JonMuller/gerbers/README.md

# gerbers
Place to store keyboard gerbers

These are gerbers for keyboards I have tweaked to suit my needs either by adding or subtracting things from the originals.
