JonMuller/gerbers/tenax-XIAO/README.md

###Updatre as of 04/14/23### Modified ZMK starter files for newest updates. Should work as is.

###Update as of 03/11/23### Added build pics and starter files for ZMK.

###Update as of 03/06/23###
I had some of these made and I built one. Pics to follow when I have a chance, but this is confirmed as working. No issues so far. Displays and all. I will also try to post the basic ZMK files needed to get this up and running.
###End update####

Modified the original from a direct pin setup to a matrix with XIAO controllers. Removed the TRRS, added power switch (Note the board will not charge unless the power switch is in the on position) and added a place to connect a battery. 

Original can be found here: https://github.com/toniz4/tenax

This was mostly routed using Freerouting. Gerbers/BOM/CPL were auto generated by the JLCPCB Kicad Plugin.

There is an issue with the way the footprints lined up for the CPL file. I wouldn't recommend using it at this time.

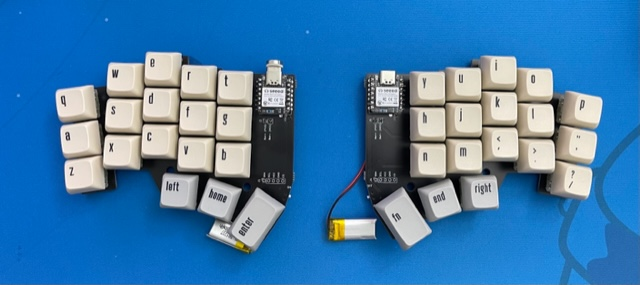
[picture p1: tenax-XIAO/Build Pics/IMG_3815.jpg]
Build1


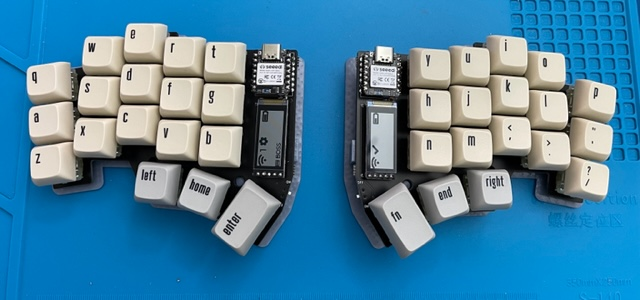
[picture p2: tenax-XIAO/Build Pics/IMG_3839.jpg]
Build2


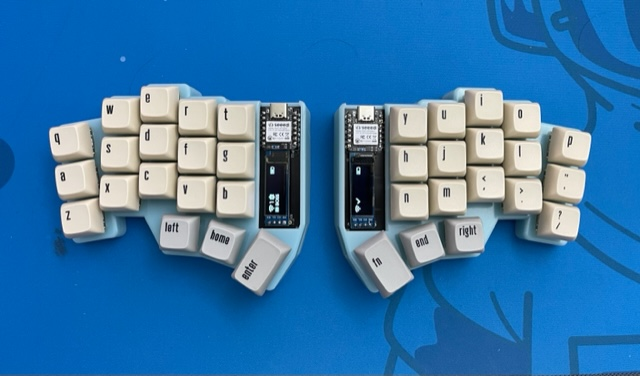
[picture p3: tenax-XIAO/Build Pics/IMG_4033.jpg]
Build3


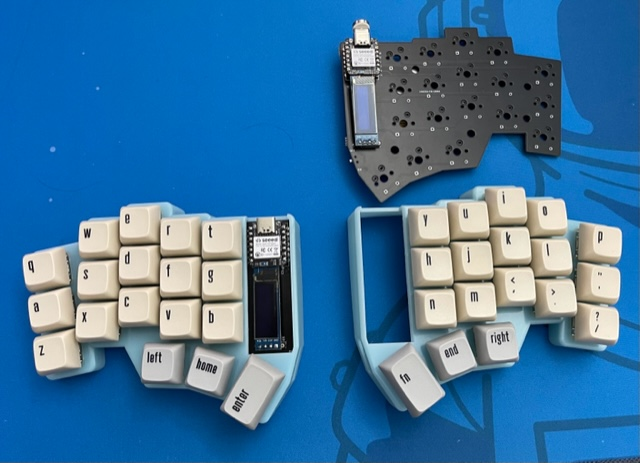
[picture p4: tenax-XIAO/Build Pics/IMG_4031.jpg]
Build4


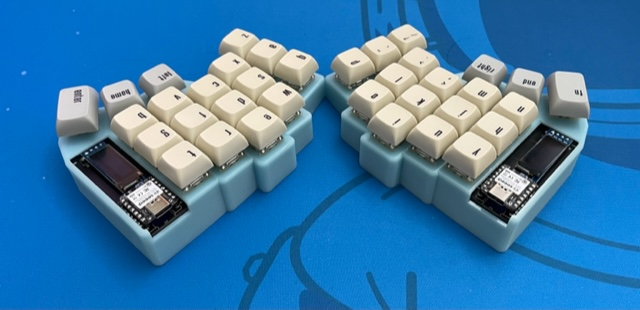
[picture p5: tenax-XIAO/Build Pics/IMG_4035.jpg]
Build5


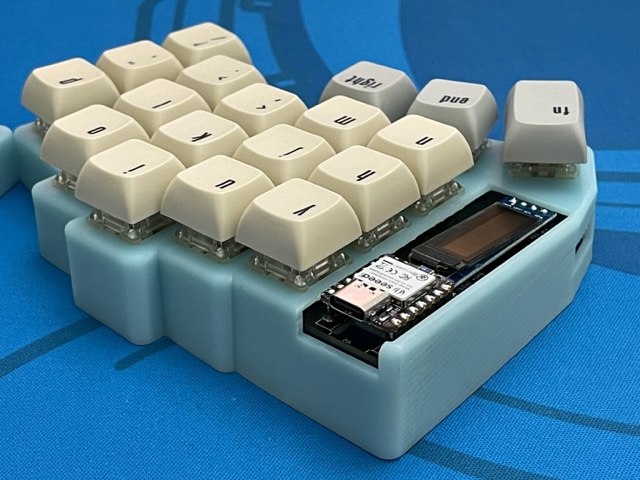
[picture p6: tenax-XIAO/Build Pics/IMG_4036.jpg]
Build6


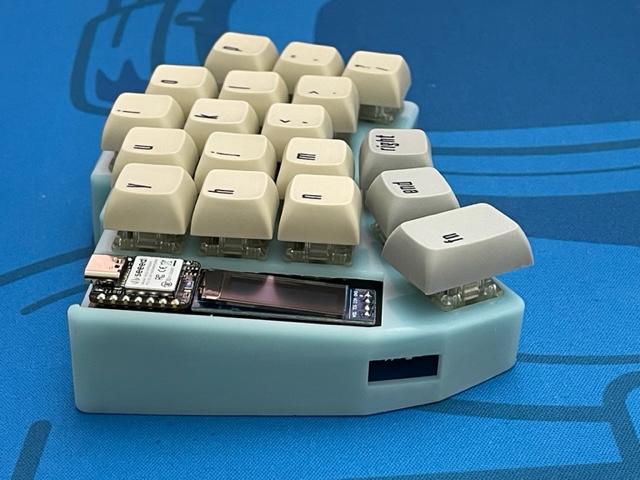
[picture p7: tenax-XIAO/Build Pics/IMG_4037.jpg]
Build7


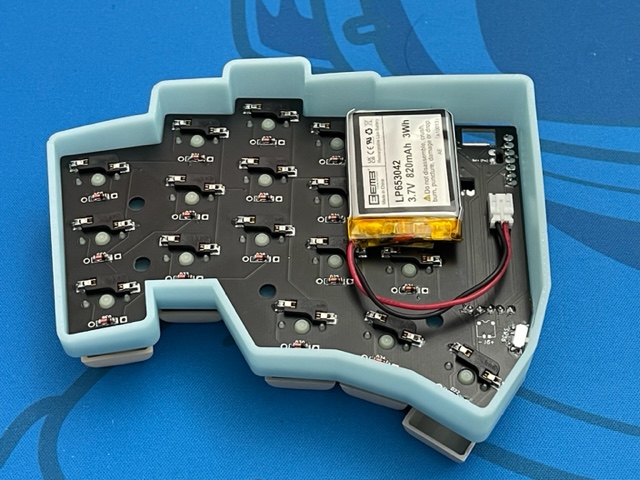
[picture p8: tenax-XIAO/Build Pics/IMG_4038.jpg]
Build8


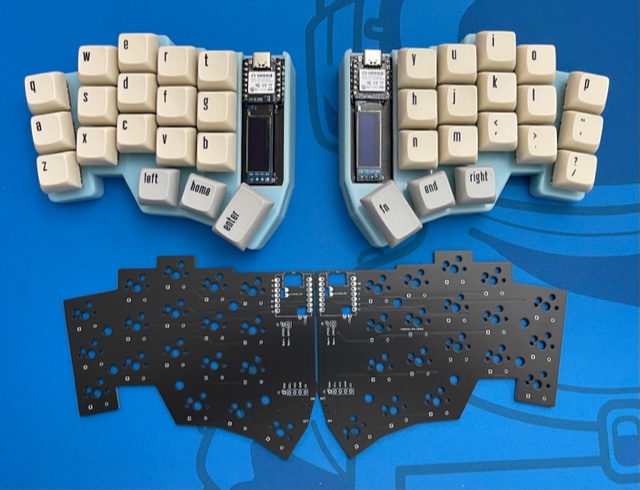
[picture p9: tenax-XIAO/Build Pics/IMG_4040.jpg]
Build9


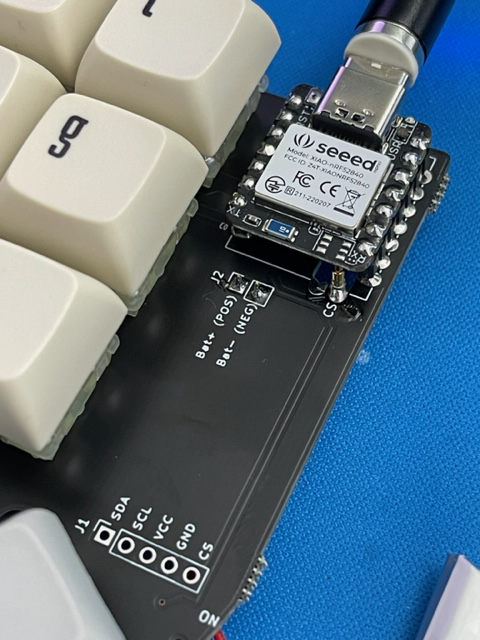
[picture p10: tenax-XIAO/Build Pics/IMG_3817.jpg]
Build10


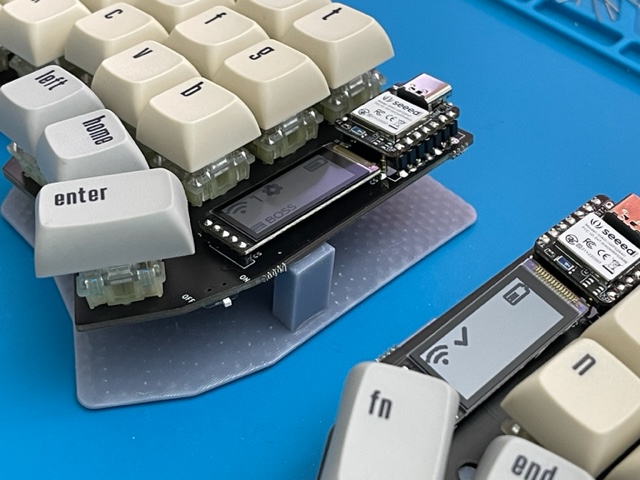
[picture p11: tenax-XIAO/Build Pics/IMG_3841.jpg]
Build11


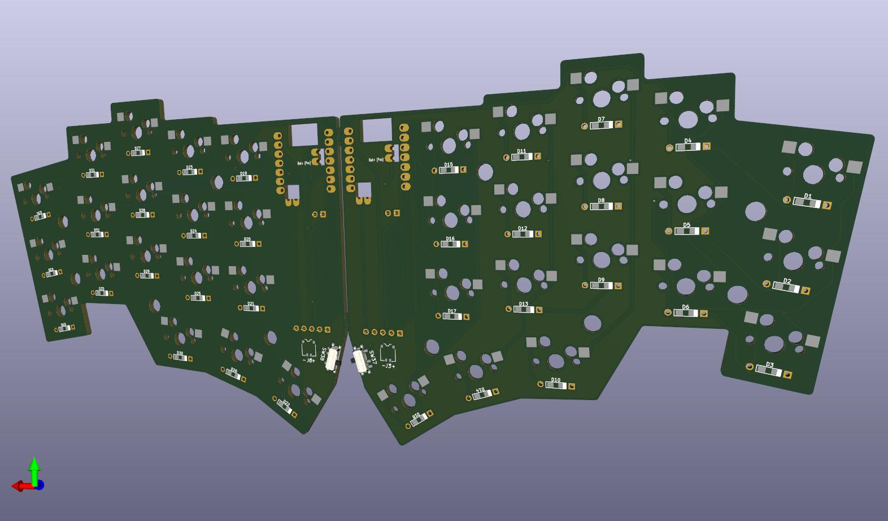
[picture p12: tenax-XIAO/tenax-XIAO Bottom.jpg]
Bottom


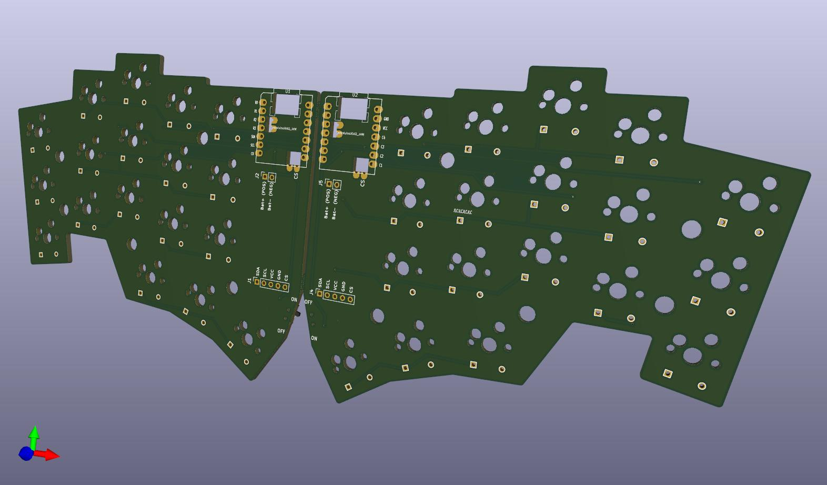
[picture p13: tenax-XIAO/tenax-XIAO Top.jpg]
Top


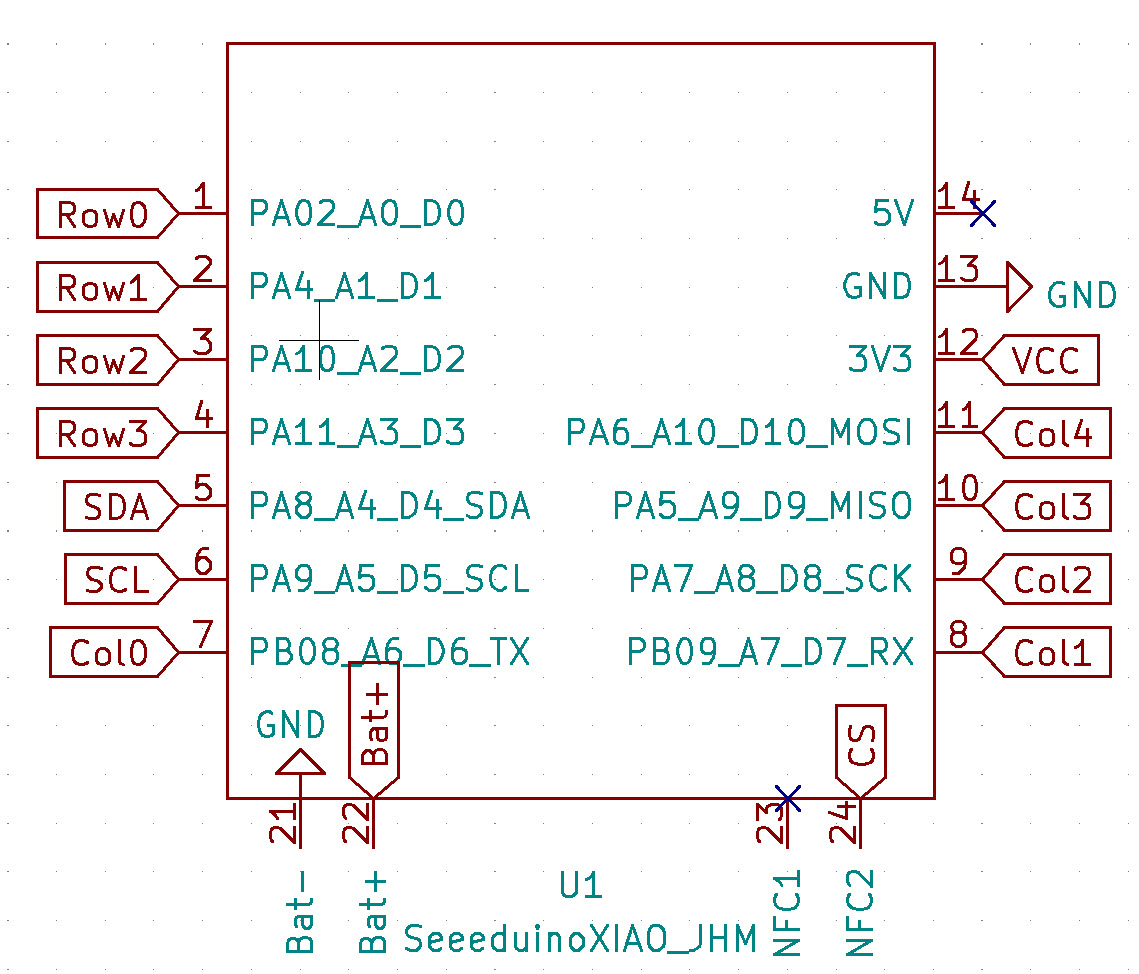
[picture p14: tenax-XIAO/XIAO_Connections.jpg]
Connections


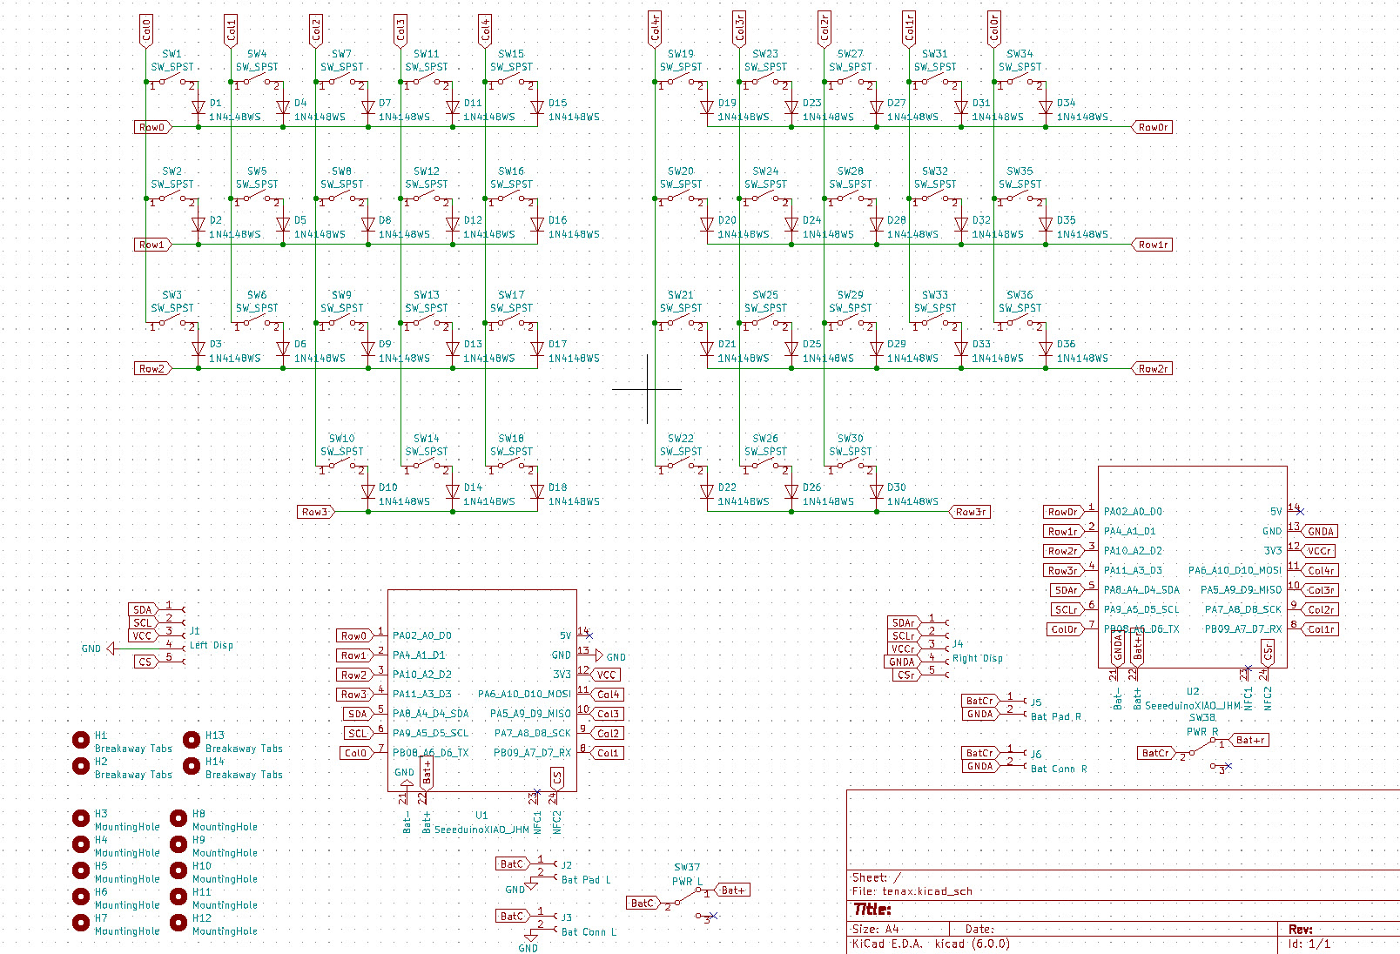
[picture p15: tenax-XIAO/Schematic.jpg]
Schematic
