JonMuller/gerbers/WirelessSofle/Alt_Switch/README.md

This is an alternate power switch layout. It uses much larger slide switches that can be easily mounted on either side as they are through hole.

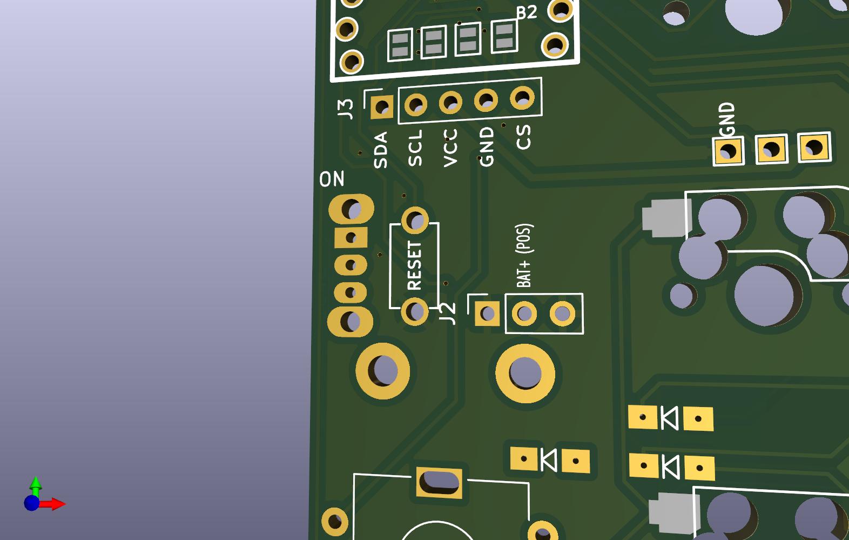
[picture p20: WirelessSofle/Alt_Switch/Closup_on_switch.jpg]
Switch Close Up

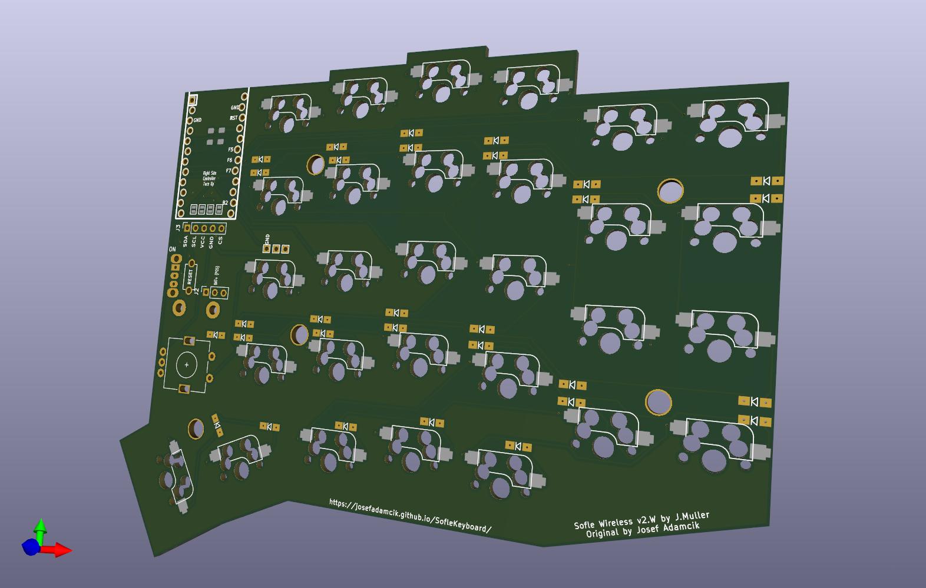
[picture p21: WirelessSofle/Alt_Switch/SofleKeyboard Top.jpg]
Top

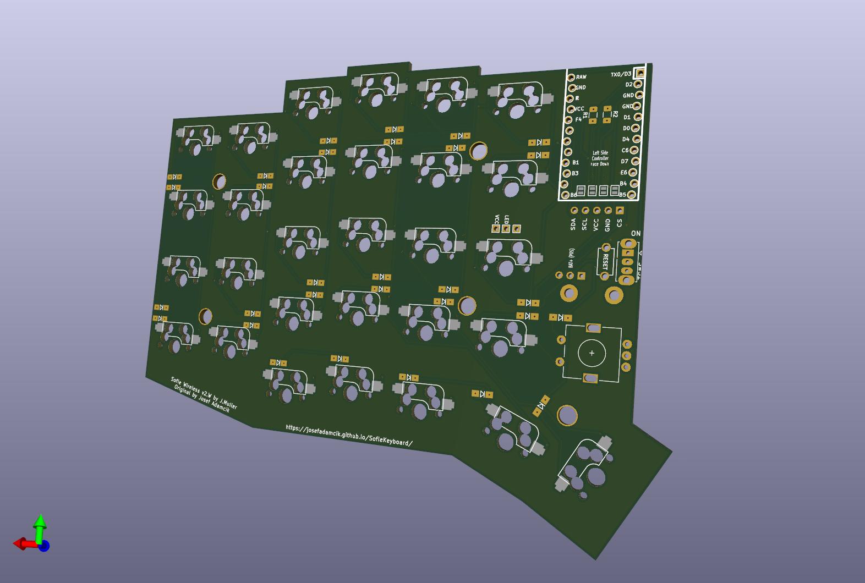
[picture p22: WirelessSofle/Alt_Switch/SofleKeyboard bottom.jpg]
Bottom
