JonMuller/gerbers/corne-choc-xiao/schematics/choc_corne_flip.jpg

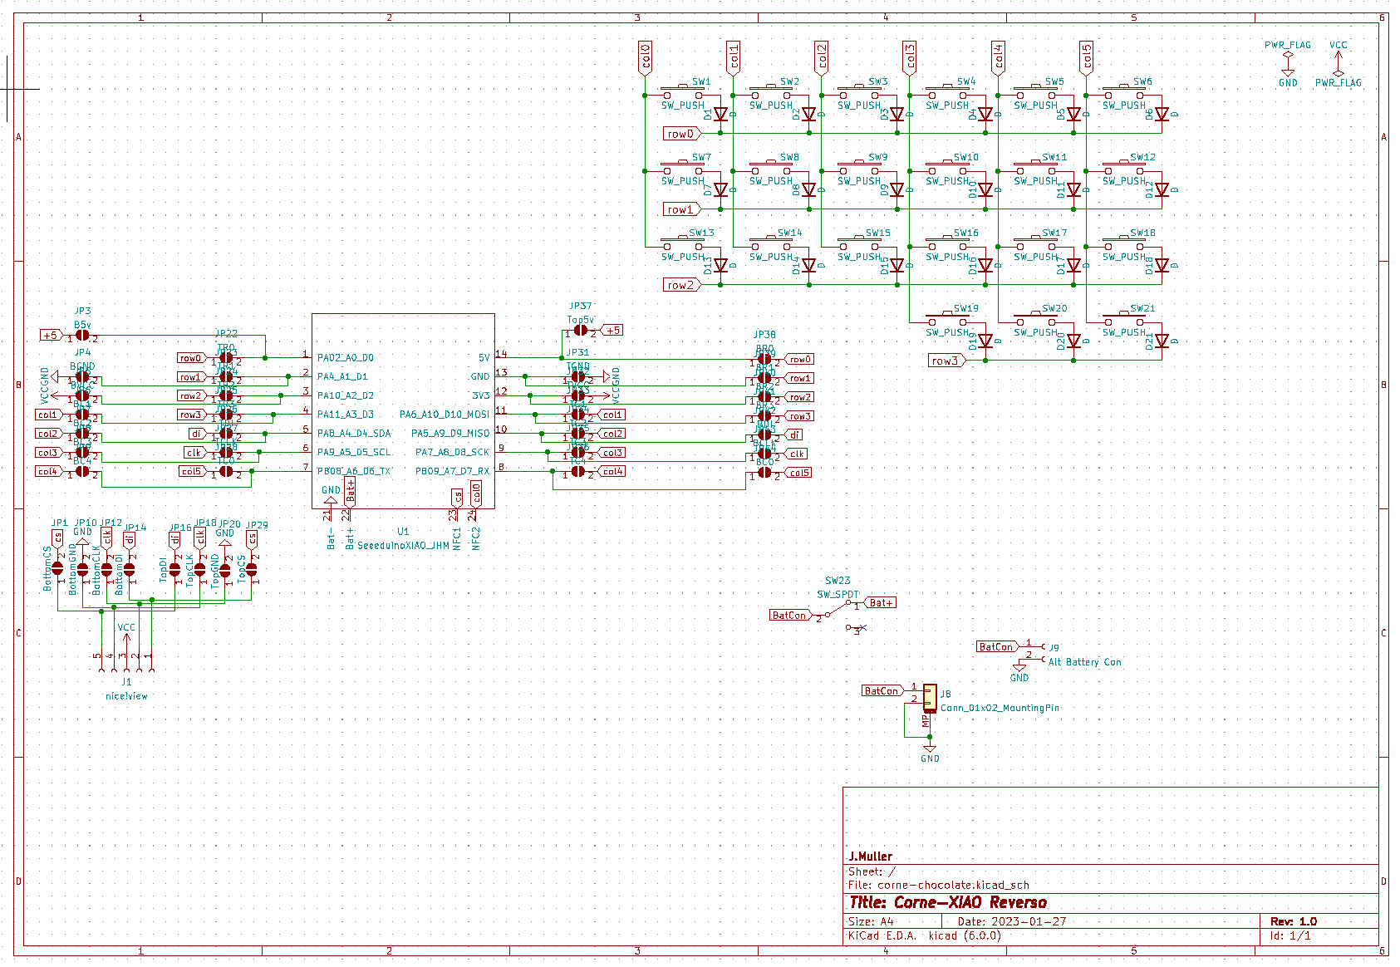
corne-choc-xiao/schematics/choc_corne_flip.jpg
