JonMuller/gerbers/corne-choc-xiao/schematics/col_rows.jpg

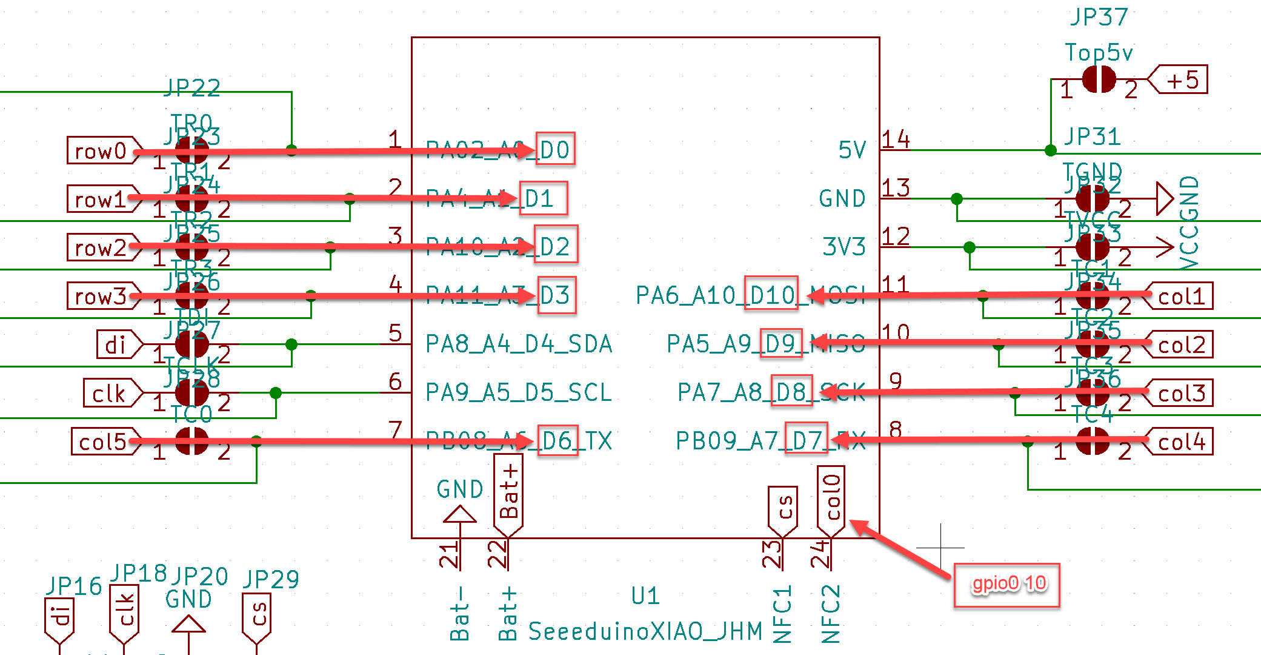
corne-choc-xiao/schematics/col_rows.jpg
