JonMuller/gerbers/corne-choc-xiao/schematics/Columns.jpg

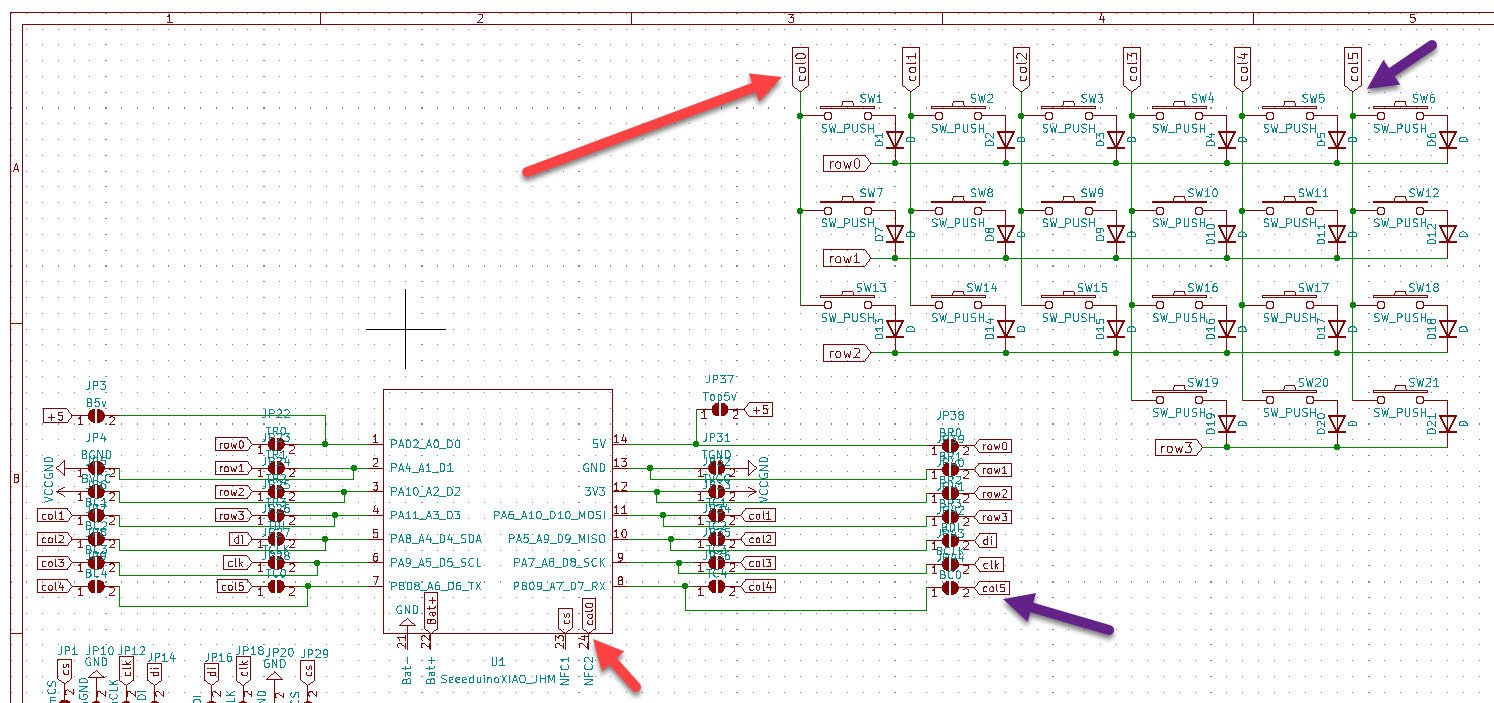
corne-choc-xiao/schematics/Columns.jpg
