JonMuller/gerbers/corne-choc-xiao/schematics/pin_def.jpg

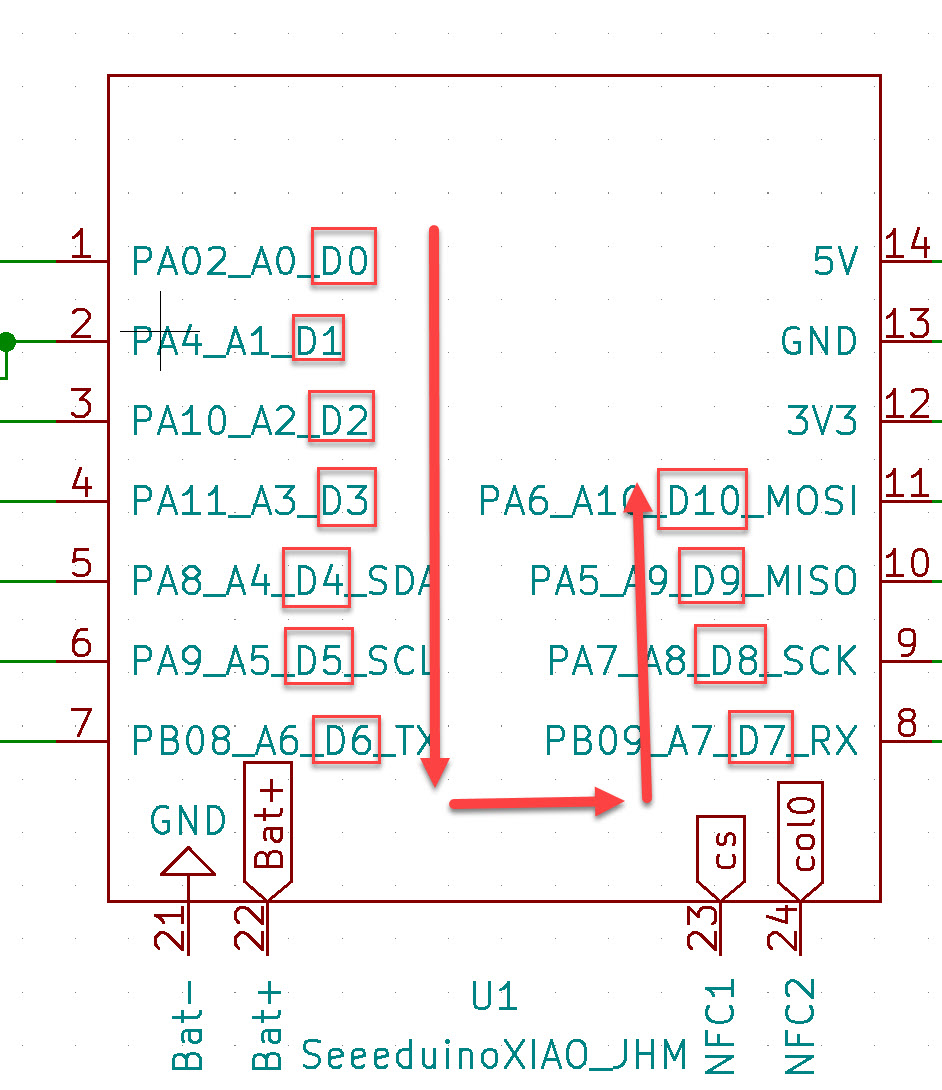
corne-choc-xiao/schematics/pin_def.jpg
