JonMuller/gerbers/tenax-XIAO/BOM-tenax.csv

Comment | Designator | Footprint | LCSC
PWR | SW38,SW37 | SW_SPDT_PCM12 | C221841
Bat Conn | J6,J3 | Molex_Pico-EZmate_78171-0002_1x02-1MP_P1.20mm_Vertical | C505023
1N4148WS | D36,D35,D34,D33,D32,D31,D30,D29,D28,D27,D26,D25,D24,D23,D22,D21,D20,D19,D18,D17,D16,D15,D14,D13,D12,D11,D10,D9,D8,D7,D6,D5,D4,D3,D2,D1, | Diode-Hybrid-Back | C2972761
