JonMuller/gerbers/ChocSpacedV4/final_choccorneV4_top_right.step

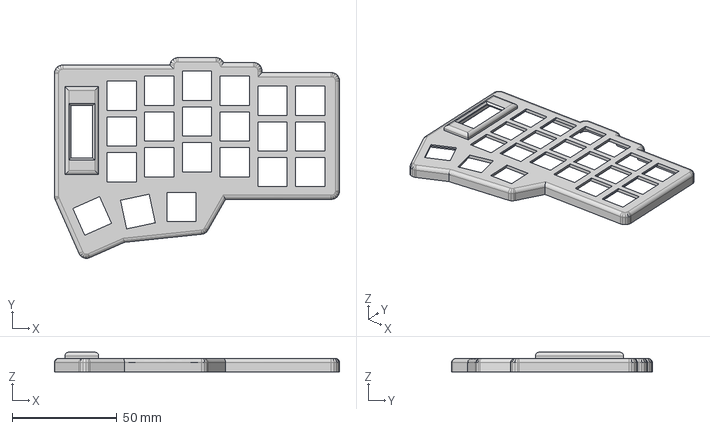
[picture p27: CAD file, 2024-07-19]
ChocSpacedV4/final_choccorneV4_top_right.step
136.1 x 95.9 x 9.40 mm
