JonMuller/gerbers/corne-choc-xiao/case/chipper_right v2.stl

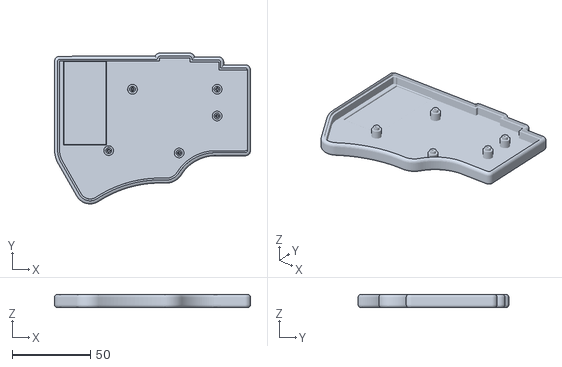
[picture p28: CAD file, 2023-03-26]
corne-choc-xiao/case/chipper_right v2.stl
125.2 x 96.3 x 8.60
