JonMuller/gerbers/tenax-XIAO/case/tenax_case_left.stl

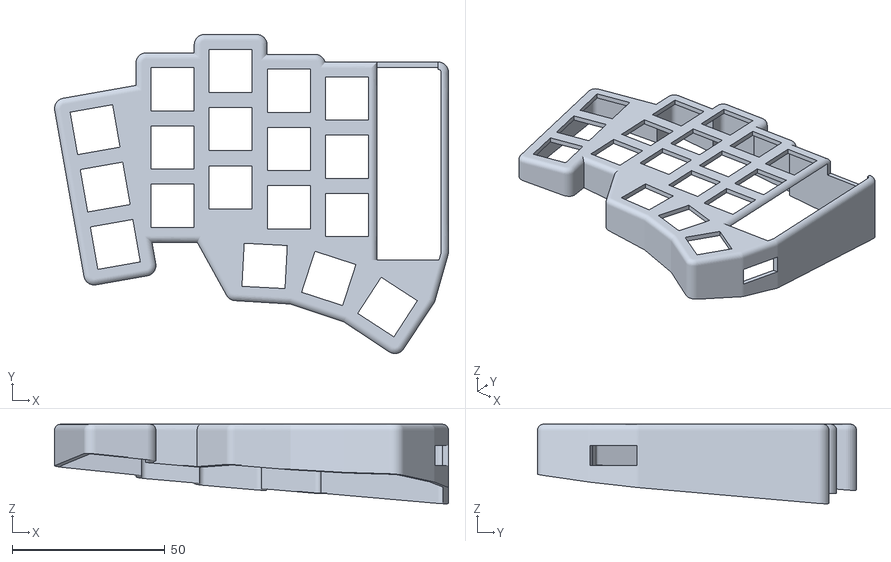
[picture p29: CAD file, 2023-05-22]
tenax-XIAO/case/tenax_case_left.stl
128.8 x 104.3 x 26.0
