JonMuller/gerbers/ChocSpacedV4/final_choccorneV4_bottom_right.step

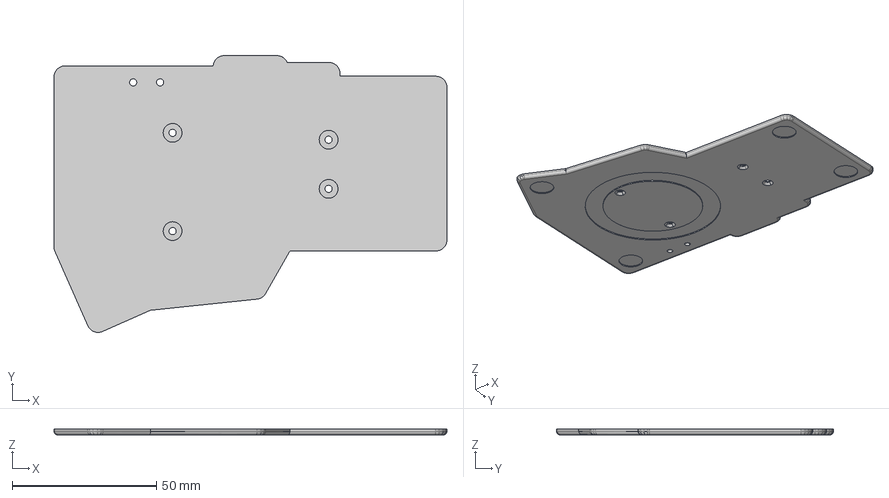
[picture p30: CAD file, 2024-07-19]
ChocSpacedV4/final_choccorneV4_bottom_right.step
136.1 x 95.9 x 2.00 mm
