JonMuller/gerbers/ChocSpacedV4/final_choccorneV4_tray_right.step

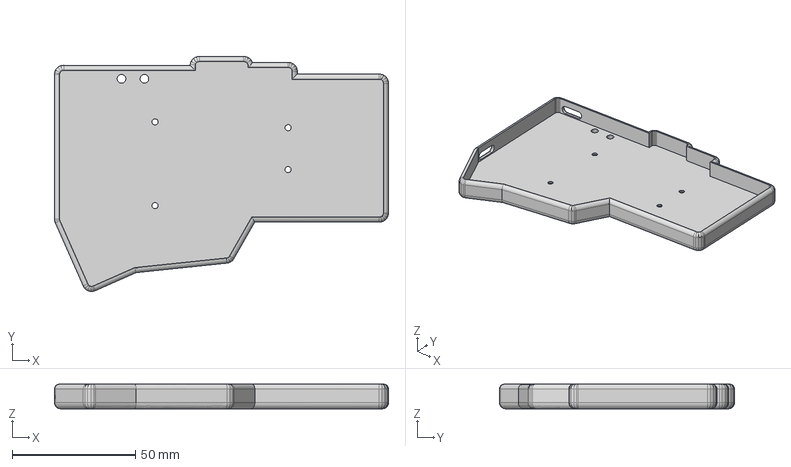
[picture p31: CAD file, 2024-07-19]
ChocSpacedV4/final_choccorneV4_tray_right.step
135.7 x 95.5 x 10.0 mm
