JonMuller/gerbers/(list of files, cad)

Other CAD files:
tenax-XIAO/case/tenax_case_right.stl
ChocSpacedV4/final_choccorneV4_top_left.step
ChocSpacedV4/final_choccorneV4_bottom_left.step
ChocSpacedV4/final_choccorneV4_tray_left.step
