JonMuller/gerbers/tenax-XIAO/Build Pics/README.md

Not surprisingly, these are a bunch of pics of an actual build.
