JonMuller/gerbers/corne-choc-xiao/experimental/ReadMe.md

This has not been validated yet. I'm attempting to upload the raw kicad files. As of 06/24/24, this is completely untested. Please let me know if this works for you or not.

Thanks and have a wonderful day!
