JonMuller/gerbers/(threads)

Thread 2 (2023-03-25):

Questions regarding battery life & 3D print case

j1n6, 2023-03-25:
Hi there, thanks for sharing the design. They look absolutely interesting. I'm planning to build one for myself.
I have a couple of questions, what is the battery life for the Corne build? Would you able to share the baseplate 3D print file?

Thanks!

JonMuller, 2023-03-25:
Hi! Battery life is really hard to pin down. It really depends on the size of battery that you use. I'm getting at least a couple of weeks with the joycon batteries. That's got a lot to due with the displays being pretty power efficient. If using the OLED displays, it's probably a bit worse. I have some 800 mAh batteries on the one with OLEDs and it's been going for about 2 weeks now. Obviously no displays will get you the best battery life.

I'm working on the case files right now. They are still a work in progress, so I'd put a bit of a caution on those. I'll try to upload them soon.

j1n6, 2023-03-25:
That's pretty good battery life!
I will order the pcbs, will wait for the 3D files. Thank you for sharing your design, love it!

JonMuller, 2023-03-26:
Case files have been uploaded. They are still a bit of a work in progress though. FYI.

tangbonze, 2023-03-27:
Thank you for share case design. Any chance also share stl for 6col pcb? Thanks.

JonMuller, 2023-03-28:
Unfortunately, I do not have a 6 col version at this time. It won't be too difficult to make one, I just don't have time right now. I might be able to get to it in a few weeks though.

tangbonze, 2023-03-30:
Can I use a corne case instead?

JonMuller, 2023-04-09:
Sorry, missed this. I don't think you can use a corne case. I moved the mount holes and I'm not sure the outline is the same. It would be iffy at best.

Closed 2023-06-03.

Thread 3 (2023-03-27):

Other epaper support

j1n6, 2023-03-27:
Do you know if it is even possible to use the follow epaper-102 display on this board?  Thank you in advance!
https://github.com/Nicell/epaper-102
Here's the pin layout:

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

JonMuller, 2023-03-28:
It's not pin compatible, no. But I wouldn't say it's impossible. I believe it requires one more pin to be wired beyond what's already available. So there would be some extra bodging necessary.

I have some of those boards and a few e-paper displays that I've tested with. If I'm being honest, the refresh rate is pretty frustrating. And the sharp memory displays are actually more power efficient. (Nice!View is a sharp memory display) so it's a tough sell for me.

Those displays are definitely supported by ZMK and it can be done, so if you really wanted to, you absolutely could. I just have a hard time recommending it.

JonMuller, 2023-04-09:
Not much else to say about this. Closing the issue.

JonMuller, 2023-04-09:
closing.

Closed 2023-04-09.

Thread 4 (2023-04-09):

Questions about the location of the diode

lu-kan, 2023-04-09:
It surprised me so much that I managed to make a working one just from the imgur pics, without a real build guide. Thank you so much!
Just want to confirm one thing: for the boards to work, the diodes MUST be soldered to the back of the left board and the front of the right board, right?

I think a tilted case will make room for even bigger batteries, so I am trying to learn CAD to make a stl for the 6-col case.

JonMuller, 2023-04-09:
If you're referring to the corne spaced XIAO, then no. It doesn't matter. I was having the diodes done at the factory, so it's much cheaper to do them all on one side. All that matters is that they are facing the right direction as far as polarity is concerned. You can place them all on the front or all on the back, whichever suits you better. You want the cathode to face the circled hole ideally, but it's configurable in whatever firmware you use. Most important is that they all are soldered the same orientation.

Hope that makes sense!

JonMuller, 2023-04-09:
Also, thanks for pointing out how helpful those pics were. I added a link.

JonMuller, 2023-04-14:
Question has been answered. Closing this issue.

Closed 2023-04-14.

Thread 5 (2023-04-19):

tenax with choc support

Shahabaz-Bagwan, 2023-04-19:
Hi, is there any chance you will create a Tenax with choc support Or [chocofi](https://github.com/pashutk/chocofi) with xiao support.

I appreciate your work, it is amazing!!

JonMuller, 2023-04-19:
Thanks! The person that asked me to convert the Tenax for XIAO did also ask about choc spacing. At the time, I almost did it but held off because I wouldn't be able to keep the mounting holes in the same location and it would have made the board incompatible with a stand that person had made. But there's no reason I couldn't take a shot at it. Just need to find the time.

Thread 6 (2023-04-25):

Kicad files?

vloth, 2023-04-25:
Thanks for sharing the project, these are some fantastic looking keebs!
I'm considering building some corne xiaos and was thinking in creating a FR4 sandwich case for 6 columns. I think I might know how to do it from the kicad. Are you planning to add the kicad files in future?
Thanks again!

JonMuller, 2023-04-27:
Thanks!
I don't have any plans at this time to sort out the kicad, but I did include the SVG files for what the plate would look like. You should be able to open a new project in kicad and in the PCB editor, File->Import->Graphics, then select the version you want, 5 or 6 col, then make sure you're on the Edge Cuts layer and you should be good. You'll have to clean it up a little more because I left in extra information you can you to reference where the display and controller go. But that shouldn't be too difficult I don't think.

vloth, 2023-04-27:
Thanks for the quick reply, I'll try the suggested method. 👍

Closed 2023-04-27.

Thread 7 (2023-05-31):

right half diodes location

j1n6, 2023-05-31:
I noticed the right half diodes is soldered on the top side, it will have contact with low profile switches.
Is it possible to solder them on the back for the right half?

thank you!

j1n6, 2023-05-31:
actually... all the low profile switch has cut out for led, it fit quite well with the diodes.

Thread 8 (2023-06-03):

6 column Xiao BLE Corne Firmware

j1n6, 2023-06-03:
I managed to solder a set together, this looks beautiful! Thank you for sharing this.
I'm now progressing to firmware... two questions:

1) any specific Changes I need to make for the firmware to support 6 columns?
2) I seem to have issues with the right half: row 0 and row 1 creates strange double keys.
     for example, if I type 'j', it output 'uj'; if I type 'u'. it also output 'uj'
     I double checked soldering, it seems to be ok.

Any thoughts?

Thank you.

JonMuller, 2023-06-05:
Yup. Sorry. I should probably include some more info for the 6 col version. You did it right though.

manna-harbour, 2023-08-07:
Here's a fix for the missing col-offset: https://github.com/JonMuller/gerbers/pull/12.

To select the 6-column transform, add this to your keymap: https://github.com/manna-harbour/miryoku_zmk/blob/b2795e263bb8ec80e2233135206befaa59776248/config/chipper.keymap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.

Thread 9 (2023-06-24):

LCSC part numbers?

JonnyHaystack, 2023-06-24:
Hi,

Love your corne choc xiao design! Is there any chance you could give some example LCSC part numbers for the diodes and molex connectors? Even if the particular part is not always in stock, it's easier to find an equivalent part when given a reference part to go off.

MuhametSmaili, 2023-07-04:
@JonnyHaystack I am checking to order this pcb too in the coming weeks and I was searching and checking the same things.

@JonMuller  as stated on the ReadeMe file he ordered the PCB via assembly hence the diodes and Molex came soldered into place.

Here are the parts that I could find (@JonMuller  can confirm)
- [Molex](https://www.digikey.fi/en/products/detail/molex/0781710002/2424924) -> Pico EZmate 1x02-MP_P1.20mm
- [Diodes I think normal SMD-123 diodes ](https://www.aliexpress.com/item/1005004188010012.html?algo_exp_id=dcf3b60b-d255-499d-b497-787991bbef9f-0)

Not 100% sure, hope @JonMuller  can confirm. These are the parts I will go If I decide to print in the near future.

Things I am checking now are:

- Printing a 6-column case for the board. (will try to modify the Jons' case to support 6 columns, but I do not own a 3d printer nor designed something myself in the past, so it will be a bit hard)
-  I will try to make the PCB not breakable to 5 columns because I think I can break on my bag I am sure that I will want 6 columns for now. I do not think I can adjust and learn typing on the 5-column layout.

Hope I could help.

JonMuller, 2023-07-05:
Hi all!
I'm sorry I didn't see this sooner!
@MuhametSmaili is correct on the parts. But to clarify, here's the LCSC #'s:
C505023 - Pico EZmate
C2972761 - diodes

I should probably update the BOM. Can be tricky when stock is out though.

Hope that helps!

JonnyHaystack, 2023-07-05:
Thanks both! I actually noticed after creating this issue that you do have the LCSC part numbers in the BOM for your tenax xiao PCB in this repo, just not for the corne choc xiao. I think both parts were well stocked also.

Closed 2023-08-08.

Thread 10 (2023-07-10):

Case for 6 column version?

Kaesono, 2023-07-10:
Is there a case somewhere for the 6 column version? Am I missing something? Or how would I be able to create my own 6 column case if so

JonMuller, 2023-07-10:
You aren't missing anything. I only made a case for the 5 column version because that's what I use. I did include an SVG file for the  6 column version though. You can use that as a starter and follow the instructions here (https://kbd.news/Keyboard-Case-Design-1764.html) to create something similar. It's a bit of a learning curve, but a very useful skill in this hobby.

Kaesono, 2023-07-10:
Is there a way that you or I could change your 5 column version of the case by extending it to have the sixth column?

JonMuller, 2023-07-10:
You might be able to, but it wouldn't be that pretty I don't think. The supports for the way you'd put a 6 column in there would need to be added.

I personally think it would be easier to just make one from scratch with the SVG file. I'm not at all opposed to doing that, but I just haven't had the time. You could try loading the current 5 column file into tinkercad online and seeing if you could split it towards the outer column, then moving it over and filling in the gap. That's pretty iffy though if you ask me. Especially if you're paying someone else to print it for you.

That' the other time issue for me. I'd like to actually print it and make sure it works before sharing. However, if I win the lottery tonight, I promise I'll have something for you by the end of the day tomorrow! So.... fingers crossed!!

Kaesono, 2023-07-10:
Is there a file for fusion360 that I could try to work with? It seems like that may be more precise than Tinkercad for this type of work.

JonMuller, 2023-07-10:
Let me see if I can find it. I'll upload it if I can.

JonMuller, 2023-07-10:
Ok, so I found it, but it will only let me save fusion files to their cloud server. I can export, but it's just in formats like .stl or .step or .obj.

I think that's a limitation of the software for personal use. Sorry about that.

Kaesono, 2023-07-10:
That's alright, could you give dimensions though for the width of each pcb key column, etc. so I can move it out the right amount. I don't think it will be too hard for me to adapt it I just need to know how much to move it over.

JonMuller, 2023-07-10:
It's standard choc spacing, so 18.5mm should do it. The last two columns are aligned the same but the screw mounts drop down. You should be fine to use the screw mounts for the 5 col, just make sure there's a shelf on the outside to support the PCB though.

JonMuller, 2023-07-10:
Check that. shelf won't work well because of the hot swap sockets. But as long as it's supported by a shelf on the top and bottom, should be ok.

Kaesono, 2023-07-10:
Could I duplicate the screw mounts and move them 18.5mm aswell? Also what is the shelf?

Kaesono, 2023-07-10:
I was thinking of just moving the outer column out and filling in the gap by duplicating parts of it in

JonMuller, 2023-07-10:
No, screw mounts don't stay at the same line. They drop down a bit.
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

Kaesono, 2023-07-10:
By how much? I could just move them down, right?

JonMuller, 2023-07-10:
This is what I mean by shelf...
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

JonMuller, 2023-07-10:
I'm not quite sure how to get an accurate measure of how much, but the .svg files are basically just exports of the cut files on kicad PCB, so if you line everything up with that, you should be good to go.

Kaesono, 2023-07-10:
What would the problem be with say moving the outer 10mm or so and filling in the remaining ledge?

JonMuller, 2023-07-11:
10mm wouldn't be enough. Needs to be at least 18.46. But otherwise, shouldn't be a huge problem.

Kaesono, 2023-07-11:
Are the two halves mirrored and otherwise identical to each other?

JonMuller, 2023-07-11:
Yup. Exact mirror. The benefit of a reversible PCB. I would just make the one change, then mirror it to make the other side. That's how I did it.

Kaesono, 2023-07-11:
Do you think the outer standoffs are necessary? I have it extended but not sure if I should put them in.
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

JonMuller, 2023-07-11:
No. I think just like that will be fine. The little shelf on the top and bottom should support the PCB.

Kaesono, 2023-07-11:
Okay, I should probably extend the middle bit a few tenths of a mm into the other pieces to make sure they're merged, right?

JonMuller, 2023-07-11:
If you can measure the inner walls from the left to right, should be about 138mm

JonMuller, 2023-07-11:
I thought on tinkercad there was an option to select two objects and merge them.

Kaesono, 2023-07-11:
There is but I want to make sure that it prints in one piece instead of three pieces that happen to be directly next to each other.

Kaesono, 2023-07-11:
Also I measured the inside wall-to-wall as ~138.5

JonMuller, 2023-07-11:
Depending on what you're printing on, you may want a little breathing room. I've only printed on a resin printer and things shrink a little. FDM might be better about not shrinking.

Kaesono, 2023-07-11:
Hmm I will consider that. I'm gonna try now on my Prusa Mk3 in PETG and see how it goes.

JonMuller, 2023-07-11:
I do not glue the battery in at all, but I don't see why you couldn't. I think the resin print shrinks just enough so it's pretty snug, but I did put in some screws just to be sure. Screws in PETG probably work better than in resin.

Kaesono, 2023-07-11:
I ended up printing the reft side in PLA and still have to do the right side. What kind of screws/glue would you use for the keyboard?

Kaesono, 2023-07-11:
Also what feet do you use on the bottom of your case? Mine are too small for the holes.

JonMuller, 2023-07-11:
I used M2 screws pretty much everywhere, but I don't use glue, so not sure what would be best. With no glue, the battery stayed in place pretty well.

I use 8mm bumpons. I've used some by 3M and some generics. Both fit just fine.

Kaesono, 2023-07-11:
Alright,I’ll buy some 8mm ones. Which screws do you use? Mine are too small and don’t hold the pcb down.

JonMuller, 2023-07-11:
I just bought a pack of variable length M2 screws and it came with washers, so I have those and I think it's a 4mm length M2 screw.

Like this:
https://www.amazon.com/dp/B0BB1FJJKC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

Kaesono, 2023-07-12:
I bought the pack of screws and washers and will try to put those in without the plastic breaking as it did when I tried to put my own M2 screws in recently. I also uploaded my [model to printables](https://www.printables.com/model/525505-choc-spaced-corne-xiao-6-column-case) in case anyone might need it. Are you sure that the screws and washers are big enough to hold the board in place but small enough to not interfere with the switches?

JonnyHaystack, 2023-07-28:
I have modelled this from scratch in build123d last week using the 6col SVG - though the SVG was a bit problematic (incorrect units, poorly formed, etc) so had to be optimised in Inkscape first. I used the screw hole locations from the SVG, so the 6th column screw posts are in the right place now.

Published here: https://www.printables.com/model/538027-abominationcorne-choc-xiao-case-6-columns

I really love this PCB, and the inclusion of BOM and CPL files made this the fastest keyboard build I've ever done. Thanks a ton @JonMuller 😄

JonnyHaystack, 2023-07-28:
By the way @Kaesono I'm guessing you've probably already figured out the screw stuff by now, but I just used some pan head M2x4 self-tapping screws with standard M2 washers and it worked perfectly fine for me. Metric screws and washers are really quite standard, and I recommend using ebay if you're searching for specific screw sizes in smaller quantities and don't want to buy a big set of screws.

tunfor-job, 2024-01-07:
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

Could you share fIxed SVG?

JonnyHaystack, 2024-01-07:
@tunfor-job it's there on the Printables page, under "other files"

Thread 13 (2023-09-19):

[Discussion] Can I build this keyboard without a display?

s5k, 2023-09-19:
Hi Jon,

I’m interested in building a budget keyboard without a display LED. Will it function properly without one?

Please forgive my lack of knowledge (this is my first time building a keyboard). I have access to PCBs, batteries, and microcontrollers, but I’m not sure what you meant by diode directions in the readme. Could you please explain how to assemble the parts correctly?

Thank you in advance.

JonMuller, 2023-09-20:
Hi there,

You can absolutely build without a display. I find them helpful for troubleshooting in the beginning, but they aren't necessary for keyboard functionality. You don't even really have to remove the code that addresses them in the firmware. OLEDs are pretty cheap depending on where you are, but they are battery hogs. Bigger batteries help negate that. Really depends on your needs. But from a bottom line cost perspective, you can absolutely skip them.

As for the diodes, they have an anode and a cathode. If you're soldering by hand, you just want to make sure you're consistent with which side you solder the anode and cathode to. I don't mean top or bottom of the board, I mean orientation on the board. Each diode location should have a square solder hole and a round solder hole. Each diode should have a marker on one side. As long as that marker is always soldered to the same solder hole, you'll be fine. You can tweak the firmware to make it work. The point of the diode is to block the flow of electricity in one direction. So you'll either block it from the rows to the columns or the columns to the rows when you press a switch. Knowing what row/column is sending a signal is how the controller determines what key was pressed. The firmware lets you pick if the rows are the input or the output. But if you aren't careful with the diodes and some are oriented from row to column and others column to row, there's no way to address that in the firmware. They just need to be consistent.

Hope that helps! Feel free to post any follow up questions!

s5k, 2023-09-21:
@JonMuller Thank you for responding to my question! As I can see in the build images, the left side diodes should be placed at the bottom side, and the right side should be placed at the top side, isn't it? (You can see in [this image](https://i.imgur.com/wqHnod8.jpeg)).

In the CPL file, the diode angle is 180°, which means I should place the diode in PCB from anode to cathode, right?
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

P/s: If there are any unacceptable words/not formal ways to ask, please forgive me, because English is not my native language.

Thank you for your attention.

JonMuller, 2023-09-22:
Hi!
No worries on the language translation. Hopefully my English translates back appropriately for you.

As to which side the diodes belong on, the fact that some are on top and some are on the bottom is a product of the reversible design and the fact that I had the diodes put on at the factory. Since they do a single side at a time, they were all technically put on the same side, but when you flip one over to make it the opposite hand, it ends up on the bottom. If you are hand soldering, just make sure to put them all the same way, i.e. Cathode always goes to the circular hole. That's the key, keep them all the same. As long as all diodes are the same, then you can make it work in the firmware.

Hope that helps!

Thread 14 (2023-10-11):

kicad project files or equivalent to adjust for MX spacing

suriaribeiro, 2023-10-11:
I really like this PCB but unfortunately due to my large hands I can only handle MX spaced keys.  Do you happen to have a version with choc switches that is MX spaced? Alternatively if you don't mind sharing the Kicad project files I can give a go at spacing out the switches.

Thanks!

JonMuller, 2023-10-11:
Hi there!

Great question!! I think at one point I did do an MX spaced version. Let me look around when I have time tonight. There's a reasonable chance that the MX version had some routing issues though. Not that they couldn't be easily fixed, I just can't remember if I did fix that. I think I had the controllers oriented in a different way too. I'll look. If I don't respond fast enough (it's not intentional, trust me!!) it would probably be easier for you to just grab the standard corne kicad files and remove anything related to the regular controller and add in the XIAO. I think my footprint is semi custom though. I have to figure out how to put that on here somewhere. I have a couple of different versions. I used one not too long ago that requires surface mount but drops out all the jumpers needed for making a reversible PCB.

Alternatively, the Tenax project is MX spaced. It's not that different really, just uses some splay and a slightly more aggressive stagger. It's a little more expensive to have made though because it's not reversible, so the overall PCB is bigger, but you do get a full board with each, so the minimum will still net you 5 total boards.

suriaribeiro, 2023-10-11:
Thanks for the quick reply. Your Tenax keyboard is also great, specially the splay. However, I am keen to build a keyboard with a 6th collumn and your corne keyboard is perfect for that. In any cass, if you don't have an mx ready version but are happy to share the editable files I could give it a go in kicad

JonMuller, 2023-10-11:
I don't know why I always forget that not everyone wants the 5 column version. That reminded me that the problem with the MX version was that when you snapped off the outer column, it created an island on the ground plane, so I had to bodge some stuff. Not an issue if you leave the last column on. But I may have fixed it.

You're not by any chance in the United States, are you?

JonMuller, 2023-10-11:
Ok, I found the actual boards. I realize there's another possible issue with them... I designed them to have integrated displays, so you'd have to find yourself some bare displays (aliexpress has always been hit or miss for me) that work. The issue with the ground plane mostly impacted the displays. If you don't care about displays (and I'm only talking about the super low powered ones, like the ones used in a Nice!View) then it's even less of a concern. I also don't know that I have a great case file to share.

Just some extra info for you.

suriaribeiro, 2023-10-12:
Hi Jon,

Thanks for getting back to me. I am based in Berlin, Germany. Whilist a display would be nice, it is certainly no strictly needed.
With all that said, I was thinking about potentially adding a splay on the last 2 collumns, therefore a way to eventually edit the files would be great.

suriaribeiro, 2023-10-15:
Hi Jon, this is the board layout I was hoping to build. I really like how you went about creating the bridges to make the board reversible and would love to re-use your schematic. If for whatever reason you do no wish to share the editable files perhaps I can commission you to create gerber files using this layout?
[airus_kbd.dxf.zip](https://github.com/JonMuller/gerbers/files/12909733/airus_kbd.dxf.zip)

looking forward to your reply

JonMuller, 2023-10-16:
Hi suriaribeiro,
I'm not against sharing editable files, the problem here is me and the way I went about things. I don't know that I have them in an easily shareable format. The problem is the way I went about my libraries. I believe if I shared the files as is, the libraries would get lost and then as soon as you edit them, you would be left in the position of either having to build certain footprints from scratch or they may completely disappear all together. I really need to learn how to do this better.

Let me just make sure I understand what you're after though.
1. MX Space/switch compatibility
2. Layout matching the file you shared above
3. Reversible PCB
4. XIAO BLE compatibility?

Outside of that, what else are you expecting?
Hotswap for switches?
Display options?
What type of battery connector?
Power switches?

Anything else I'm missing?

Also, if you were to have the PCBs made, would you want any assembly done at the manufacturer? I have often let them handle the diodes. Makes it easier to use smaller SMD diodes since I don't have to worry about soldering them. But I usually have an optional through hole mount in case a diode gets knocked off or just needs to be replaced. Much easier to do that by hand.

As far as reversible PCBs go, I have 2 designs that I've done. The one with all the jumpers and one where I don't use through holes on the controllers, so they must be surface mounted. That can be seen here: https://www.reddit.com/r/ErgoMechKeyboards/comments/1456utk/little_more_xiao_ble_trouble/  There are pros and cons to each way. One does require a lot less soldering though.

suriaribeiro, 2023-10-26:
Hi Jon, someone created an mx version. Will close the issue making reference to this alternative design.
https://github.com/friction07/corne-xiao/tree/main/rev1

Closed 2023-10-26.

Thread 15 (2023-10-18):

Choc Spaced Corne matrix wiring

kevinstadler, 2023-10-18:
Hello,

first of all thanks for such an inspiring project! I'm trying to understand how you managed to do the matrix wiring while also supporting a display on the small number of pins on the Xiao, and it's quite difficult to figure this out from the Gerbers alone.

I know that some other Xiao keyboards (like the Zaphod lite) make use of an extra shift register to increase the matrix size, but your design seems to use only the Xiao pins. But with 3 GPIOs going to the display that only leaves you 8 GPIOs for the matrix, which makes me wonder how you managed to get 18 keys (or even 21 on the 6 column layout) into the matrix? Would it be possible for you to share a screenshot of the schematic maybe?

Many thanks!
Kevin

JonMuller, 2023-10-18:
Hi there!

It's actually not that complicated. If you look at the pics in the link, the last couple pictures show you a shot of the underside. The XIAO has the 11 easily available side pins, but it also has 2 semi accessible pins on the bottom that can be used. They are originally the NFC pins, but you can reset them to be just GPIO. That gives you 13 pins to work with instead of 11, so no shift register or any other fancy stuff required, just some slightly tricky soldering. The display does need to high speed pins, so I use the regular SDA/SCL pins for that, but then I borrow one of the NFC pins for the CS. Then I use the other NFC pin for the outer most column. So technically if you only cared about the 5 col version with no memory in pixel display (you could still use the older OLED displays as they only require the SDA/SCL pins), you wouldn't need to worry about the NFC pins.

Using the NFC pins isn't everyone favorite option  because they aren't as easily accessed. If you really want to get more GPIO, there's technically 3 more pins up top where the sense module goes. If you get the non-sense version of the XIAO and you have a steady hand, you can have a total of 16 GPIO on the XIAO. Those ones are pretty tricky though and I only used them in one design just to see if I could.

Does that answer your question? I can show you the schematic, but I don't know that they have an actual footprint for the NFC pin version. I had to make mine custom. And it took a little tweaking to get the positioning right. It also means basically permanent surface mount for the controller. I may eventually get a hot plate or something so I can try to desolder the controllers I have on boards where I messed up the routing, but not sure spending a couple hundred dollars to save a $10 controller is worth it just yet...

JonMuller, 2023-10-18:
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

This is the basic premise.

kevinstadler, 2023-10-18:
This is amazing, thank you so much!! My first Xiao's are still in the mail, so I wasn't aware of all the extra pins that can be used. I'd really love to include an encoder as well, so I might have to have a go at those Sense pins... I guess there's no other way than running some jumper wires to the top of the chip?

Love the reversible design with the jumpers as well! I saw in a more recent post you mentioned playing with a new reversible Xiao footprint, did you have any luck with that?

Best!

JonMuller, 2023-10-18:
That is exactly what I did with the extra sense pins. I added some through hole connectors right by where the sense pins would be once the controller was attached and I just used some magnet wire to jump from the controller to the PCB. I was able to get the encoders working without too much trouble. Encoders are better off with high speed pins, which fortunately 2 of the top 3 pins are. I've heard others get nervous about using pins so close to the antenna, but I never noticed any Bluetooth issues.

Yes, the reversible footprint worked out just fine. It's much harder to line up the controller though. Well, not harder, just takes more patience and concentration. There's no through holes to help you line it up, but also you don't have to deal with any jumpers for the regular pins. I still have jumpers for the display, but that's it. Makes routing a lot easier. I have a working chocofi with that setup that I probably should add all the gerbers for.

kevinstadler, 2023-10-22:
It looks like Xiao footprints are now also available in the https://github.com/crides/kleeb Kicad symbols library, I guess I'll have to give these a shot. Many thanks again for your help!

Closed 2023-10-22.

Thread 17 (2024-06-01):

Castellations holes are required for JLCPCB?

bullhugger, 2024-06-01:
Thank you for sharing first off, I have some questions regarding the JLCPCB process though. I received this email from JLCPCB

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

The cost is twice the normal manufacturing if including castellation holes. Is it required? Otherwise this is going far too expensive for me.

JonMuller, 2024-06-01:
Seems as though you've got an ambitious reviewer of your board. I have never paid for that and I haven't had any issues yet, but I do know what they are talking about. I've had to clean up the cuts a little before assembly.

If they will let you do it without paying the extra, just say you are fine with consequences. If they won't, there isn't much else you can do.

As to the actual consequences, the way the traces get to the pads on those holes when they are cut shouldn't be at all impacted by the cuts so long as the pads stay on the top and bottom of those holes. Worst case scenario, you'd need to bodge a wire from the switch to the battery pad on the controller. But if you're ordering 5 pcbs, the likelihood that 4 out of the 5 wouldn't work seems really low to me. Especially since it's never happened on any of mine.

bullhugger, 2024-06-02:
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

Thanks for the info. Yeah I'm gonna proceed without the castellations hole. The reviewer was indeed very ambitious, and I don't think its worth twice of the pcb price. Thanks again.

bullhugger, 2024-06-03:
Requested JLCPCB to proceed without the castellations hole

bullhugger, 2024-06-04:
Requested JLCPCB to proceed without the castellations hole

Closed 2024-06-04.

Thread 18 (2024-06-16):

Raw KiCad files?

lazerwalker, 2024-06-16:
Hi!

I'm curious if you'd consider making the full KiCad project, instead of just the gerbers, open source — your board checks off all my boxes except for not supporting replacing a key or two with rotary encoders or roller encoders, and I'd love to just fork and make that little tweak myself rather than have to recreate a lot of the layout you've already done from scratch or starting from a different project that's farther off from my goals.

Totally understand if that's not something you're willing to do!

JonMuller, 2024-06-24:
If you're up for an experiment, I can try just doing the bare minimum of effort and upload the files as is. You can then grab them and see what's broken?

lad1337, 2024-11-03:
Hi I‘m working on a keyboard that uses the xiao and want it to be reversible.
I believe you made a reversible footprint for the xiao based on your post on Reddit
https://www.reddit.com/r/ErgoMechKeyboards/s/LwAzCU8178

As I’m still new to KiCad it would help me a lot to understand if you could upload it.

JonMuller, 2024-11-04:
You are correct! I did make a reversible XIAO footprint. I have only used it once, but it did work. The trickiest thing about footprints from what I remember is that you just need to assign the same pad number to the right place. So when you're working with the top side, say you assign the upper left pad the number one, then you need to also assign the number one to the bottom pad on the upper right. And you can't use through hole options when doing that. That just ensures that when you route things, they are going to the correct place. I'll see if I can figure out how to extract a footprint. I'm a bit busy right now, so it may take some time.

I will also say from experience that just looking at a footprint in KiCad was not super helpful to me. Not everything was obvious by sight. I had to really dig into the settings/config of it to understand what all was happening.

lad1337, 2024-11-05:
hey thanks for your feedback.
i gave it a shot and created a shot and created https://gist.github.com/lad1337/6de9173f0fbd4676588e0da8372f2eef have not yet tried it

JonMuller, 2024-11-08:
No worries @gabriel-viviani. That 3rd orange keyboard is a corn-ish zen. It uses an e-ink display. Depending on how good you are (if this is your first build, then I would say maybe not ready yet, but maybe just first keyboard build? not first soldering experience?) you could possibly add one of these, but they require at least 5 gpio as opposed to the 3 for the N!V or 2 for the OLED. They are a bit more expensive than the OLEDs though, but still cheaper than N!V. If I'm being completely honest though, I do not care for them. The refresh rate is pretty tough to get used to. Most people just use them for overall connection status and battery levels, not for layer indicators or anything else. Your most cost effective option would be to go with an OLED and then look for a battery that is in that 500mAh+ range. I really like the Nintendo JoyCon batteries for this because I think they're likely the easiest to source? but I could be wrong on that.

I hope it goes well and you enjoy it! Please feel free to ask any other questions. You can ask here or try bugging me on reddit.

Thread 20 (2024-12-06):

Diode and Battery connector

johnnytshi, 2024-12-06:
Hi,

My PCB has finally arrived, and I’d like to double-check two things before I start:

1. For the diodes, in your photo I see that on the right-hand side they are soldered on the top rather than the bottom (due to PCBA constraints). My understanding is that I can place them on the bottom side, as long as the cathode aligns with the circular hole. Is that correct?

2. For the battery connector, I believe I need [[this component](https://www.aliexpress.com/item/1005006478369838.html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)](https://www.aliexpress.com/item/1005006478369838.html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). Should I solder all four points? are the additional two just for extra structural support?

All the best,

Johnny

johnnytshi, 2024-12-06:
forgot to ask, what is J9 for? doesn't seem like thats used based on your pictures

JonMuller, 2024-12-06:
Hi,

1. Correct. Just keep everything facing the same way and worst case scenario you just have to adjust the firmware for diode direction.

2. That does look like it should work. It's hard to say for sure without actual physical measurements, but if it's designed to work with a joycon connector, then it should fit the footprint on the board. The additional points on the back of the connector are both connected and for structural support. They are connected to GND, but if you don't solder them, it will still work. But if you unplug the battery, do so very carefully. It's generally a tight fit to begin with.

As for J9, that is just a secondary spot to solder a battery without a connector. So if you were using any number of available lipos, you could just solder them directly and not worry about the connector.

Hope that helps!

johnnytshi, 2024-12-07:
Make perfect sense. Thanks again!

Closed 2024-12-07.

Thread 21 (2024-12-26):

Which side to solder displays on

sumrdev, 2024-12-26:
Hi :) Thanks for this project its really cool, everything works for me except the displays. I soldered them on the bottom of my boards, but i suspect that might be wrong?

Thread 22 (2025-01-17):

Having trouble build row2col for corne-choc-xiao

johnnytshi, 2025-01-17:
Hi,

Finally got my Xiao after the long Canada Post delay. Do you know what I need to change to build row2col?

Here is what I did:

1. moved all the files inside zmk_starter/view into a zmk-config (added a build.xml)
2. inside chipper.dtsi, change the diode-direction = "row2col";

it did build, https://github.com/johnnytshi/zmk-config/tree/master
however, when i press a key, the keyboard would issue seemingly random keys, for example, when i use evtest, and press "a", i get the following:
Testing ... (interrupt to exit)
Event: time 1737144001.653905, type 4 (EV_MSC), code 4 (MSC_SCAN), value 70014
Event: time 1737144001.653905, type 1 (EV_KEY), code 16 (KEY_Q), value 1
Event: time 1737144001.653905, -------------- SYN_REPORT ------------
qEvent: time 1737144001.869496, type 4 (EV_MSC), code 4 (MSC_SCAN), value 70083
Event: time 1737144001.869496, type 1 (EV_KEY), code 240 (KEY_UNKNOWN), value 1
Event: time 1737144001.869496, -------------- SYN_REPORT ------------
Event: time 1737144002.121851, type 1 (EV_KEY), code 240 (KEY_UNKNOWN), value 2
Event: time 1737144002.121851, -------------- SYN_REPORT ------------
Event: time 1737144002.155421, type 1 (EV_KEY), code 240 (KEY_UNKNOWN), value 2

and it does NOT end

I also retried the firmware here: https://github.com/JonMuller/gerbers/tree/main/corne-choc-xiao/zmk_starter/view/firmware/row2col
The left one works, (however, i need 6 col instead 5). But the right one did NOT work at all.

any idea what I should do?

All the best

Johnny

JonMuller, 2025-01-17:
First, let me apologize. I did not consider 6 column people at all when I added all the starter code and I regret that. It probably makes it look easier than it is.

So for starters, you'll want to change the transform to the 6 column default one. On line 12 in your dtsi file:
Change = five_column_transform
to = default_transform

Then you'll need to add &kp [insert whatever key you want] at the beginning and end of the top 3 rows for each layer in the keymap. Thumbs are find because nothing changes there. So if that's &kp ESC or &kp TAB or whatever, you'll need to add those in so those outer keys actually work. I think you'll get an error on build if you don't at least put &trans in there.

Also, all those combos will be off from their intended location because now the count starts one switch to the left.

Once you make those changes and you successfully compile, then load that and see where we're at.

To be fair though, most of that shouldn't matter. When you loaded the test firmware and the left side worked (minus the outer column) that suggests the board and controller are sound, so your firmware should have worked.

How much of the assembly did you do yourself? That would be the next thing to look at. All the soldering and such.

johnnytshi, 2025-01-18:
I did all the assembly by hand. I built the Sofle Choc that I am using currently, but I have been slowly removing more keys , now to the point I can move to a corne style wireless keyboard, and this is probably the slimmest one.

ok, good news is finally all the keys worked. i think "CONFIG_NFCT_PINS_AS_GPIOS=y" tripped me up. now the remaining issue is my right side. The firmware still doesn't respond to any key presses.

Interestingly, if I flash the left-side firmware onto the right side, all six columns work correctly—though, of course, the key mapping is incorrect. The same is true for the firmware provided by you, right side would respond to keys if flashed with lift side firmware

any idea?

JonMuller, 2025-01-19:
Sorry! Didn't see this until the morning. No worries at all. I would just remove the stuff about you being dumb. There's often stuff I take for granted being around this for awhile now. It's good that you documented where your exact issue was. You are correct. The right is just a peripheral. It needs the left to work completely.

I hope it works well for you and you enjoy it!

johnnytshi, 2025-01-20:
It works great, now I am just waiting for the battery + connector

For anyone else interested, this is a really great keyboard. It is a bit narrower than corne (I only have v4 to compare), which I find somehow makes it more pleasant to type. Also, the thumb cluster is more ergo compared to corne

Closed 2025-01-18.
