JonMuller/gerbers/(list of files, drawings)

Other design files:
corne-choc-xiao/experimental/chocspacesharp2.dsn
corne-choc-xiao/experimental/chocspacesharp3.dsn
corne-choc-xiao/experimental/chocspacesharp4.dsn
corne-choc-xiao/experimental/chocspacesharp.dsn
corne-choc-xiao/experimental/xiaoReverso.dsn
corne-choc-xiao/experimental/xiaoReversov2.dsn
corne-choc-xiao/experimental/xiaoReversov3.dsn
