JonMuller/gerbers/(commit log)

2023-01-22 Add files via upload
    Reworked to use XIAO BLE as the controller. Added support for displays (OLED or Nice!View), power switch and battery connector/alternate battery connection as well as a diode matrix. Original was direct pin.
    [BOM-tenax.csv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]
2023-07-30 Add LCSC part numbers to corne-choc-xiao BOM
    [BOM-corne-choc-xiao.csv]
2024-02-11 Update README.md
    added note about choc spacing of switches.
2024-07-19 Update and rename final_choccorneV4_bottom_left.step to ChocSpacedV4/final_choccorneV4_bottom_left.step
    [final_choccorneV4_bottom_left.step]
2024-07-19 Update and rename final_choccorneV4_bottom_right.step to ChocSpacedV4/final_choccorneV4_bottom_right.step
    [final_choccorneV4_bottom_right.step]
2024-07-19 Update and rename final_choccorneV4_top_left.step to ChocSpacedV4/final_choccorneV4_top_left.step
    [final_choccorneV4_top_left.step]
2024-07-19 Update and rename final_choccorneV4_top_right.step to ChocSpacedV4/final_choccorneV4_top_right.step
    [final_choccorneV4_top_right.step]
2024-07-19 Update and rename final_choccorneV4_tray_left.step to ChocSpacedV4/final_choccorneV4_tray_left.step
    [final_choccorneV4_tray_left.step]
2024-07-19 Update and rename final_choccorneV4_tray_right.step to ChocSpacedV4/final_choccorneV4_tray_right.step
    [final_choccorneV4_tray_right.step]
